snowyfoams/dog5/dog5_sdk/dog5_sdk/model/meshes/hip.stl

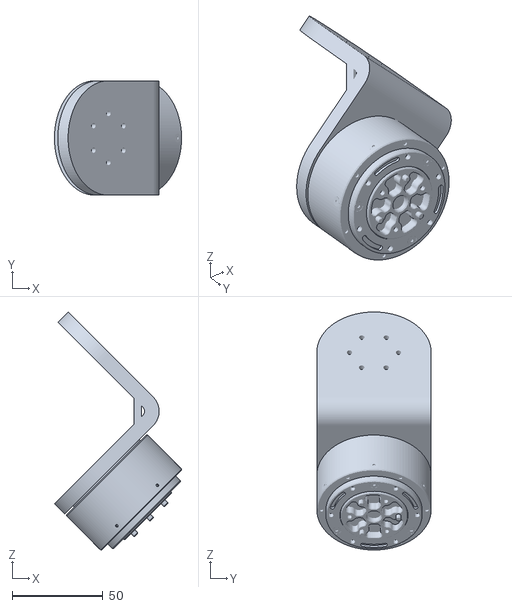
[picture p12: CAD file, 2026-08-26]
dog5_sdk/dog5_sdk/model/meshes/hip.stl
70.0 x 63.0 x 131.0
