snowyfoams/dog5/dog5_sdk/dog5_sdk/model/meshes/thigh.stl

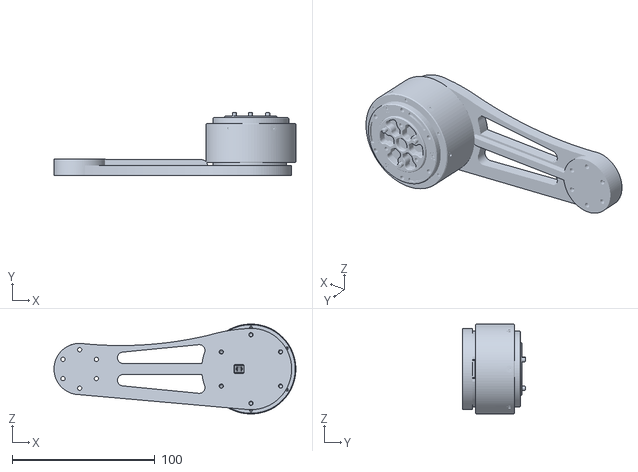
[picture p13: CAD file, 2026-08-26]
dog5_sdk/dog5_sdk/model/meshes/thigh.stl
169.6 x 44.0 x 63.0
