snowyfoams/dog5/dog5_sdk/dog5_sdk/model/meshes/shin.stl

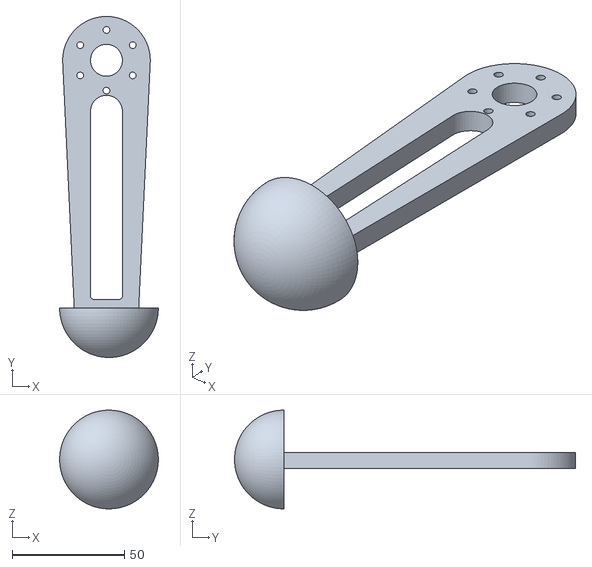
[picture p14: CAD file, 2026-08-26]
dog5_sdk/dog5_sdk/model/meshes/shin.stl
44.0 x 151.9 x 44.0
