snowyfoams/dog5/dog5_sdk/dog5_sdk/model/meshes/trunk.stl

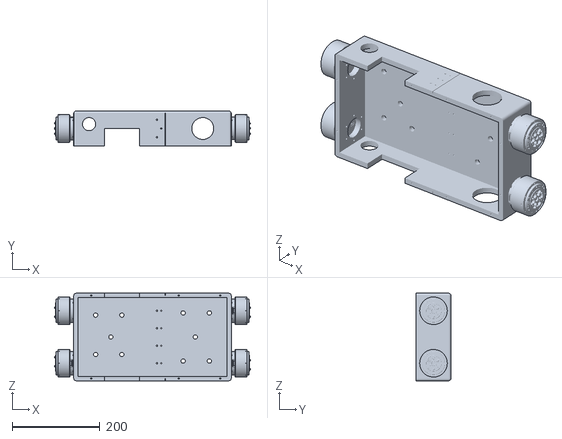
[picture p15: CAD file, 2026-08-26]
dog5_sdk/dog5_sdk/model/meshes/trunk.stl
448.0 x 80.0 x 200.0
