snowyfoams/dog5/dog5_sdk/dog5_sdk/sim.py

"""The MuJoCo backend: the same API as the robot, on the shipped MJCF.

    from dog5_sdk import Dog5Sim, JointPD, poses

    with Dog5Sim(pose="crouch", viewer=True) as robot:
        robot.run(JointPD(poses.stand_pose(0.15)), duration=5.0, tau_max=6.0)

WHAT THE MODEL IS
    ``model/dog5.xml`` is the robot's own MJCF, exported from the CAD and
    shipped here with its four meshes.  Its inertials are the CAD's, its
    ``armature`` is the real rotor inertia reflected through the 10:1
    reduction, and its actuators are direct-drive ``motor`` actuators with
    ``gear=1`` -- so ``data.ctrl`` IS joint torque in N*m, in the same units
    and the same order as the torque you send over CAN.  That is what makes
    one controller run on both.

    Bodies, joints, actuators and ``qpos[7:]`` are all in the canonical order
    (see :mod:`dog5_sdk.poses`), but this module looks every index up BY NAME
    anyway, so a future edit to the XML cannot silently transpose a leg.

WHAT THE SIMULATOR IS NOT
    It has no CAN bus, so no missed replies, no input-lost latch, no driver
    temperature and no 4 ms of round-robin phasing between the twelve joints.
    It has a rigid floor with MuJoCo's contact model, not a real one.  A
    controller that stands here will not necessarily stand on the robot -- the
    stack this SDK comes from documents a run where it did not.  What the
    simulator IS good for is the things that are true in both: the geometry,
    the mass distribution, the sign of every joint, the shape of your control
    law, and whether it saturates the torque cap.
"""
from __future__ import annotations

import math
import os

import numpy as np

from . import params as P
from . import poses
from .base import Dog5Robot
from .estimate import EncoderVelocity, leg_frames_all, trunk_estimate
from .hardware_map import HARDWARE_JOINTS
from .poses import LEGS, N_JOINTS
from .state import RobotState

#: The MJCF and its meshes, shipped inside the package.
MODEL_DIR = os.path.join(os.path.dirname(os.path.abspath(__file__)), "model")
MODEL_XML = os.path.join(MODEL_DIR, "dog5.xml")

#: Per-foot normal force counted as contact.  The robot weighs 57 N, so a
#: foot carrying 1 N is carrying nothing; this is a contact test, not a load
#: measurement.
CONTACT_FORCE_N = 1.0

#: Gains for the simulated position mode (``move_to``).  They stand in for the
#: drivers' own 0xA4 loop, which is a current-mode servo inside the motor and
#: is not modelled -- see the note in :meth:`Dog5Sim.move_to`.
POSITION_KP = 80.0
POSITION_KD = 3.0


def rpy_from_mat(mat) -> np.ndarray:
    """Roll, pitch, yaw from a body->world rotation matrix.

    Roll and pitch use the SAME definition as the hardware estimator
    (``estimator.C_from_rp`` / ``dynamic_model.attitude_rp``): the inertial
    up-axis expressed in the body frame.  A level robot reads 0, 0.
    """
    mat = np.asarray(mat, dtype=float).reshape(3, 3)
    g_b = mat.T @ np.array([0.0, 0.0, 1.0])      # up-axis, in the body frame
    roll = math.atan2(g_b[1], g_b[2])
    pitch = math.atan2(-g_b[0], math.hypot(g_b[1], g_b[2]))
    yaw = math.atan2(mat[1, 0], mat[0, 0])
    return np.array([roll, pitch, yaw])


class Dog5Sim(Dog5Robot):
    """DOG5 in MuJoCo, behind the :class:`dog5_sdk.base.Dog5Robot` interface.

    pose      starting pose: "crouch", "zero", "stand", or a (12,) vector
    viewer    open the interactive MuJoCo viewer (needs a display)
    realtime  pace the loop to wall-clock; off by default, because a headless
              run should go as fast as it can
    gravity   set to 0.0 to float the robot -- useful for checking a leg
              controller without the trunk falling over
    """

    name = "dog5-sim"

    def __init__(self, pose="crouch", *, viewer: bool = False,
                 realtime: bool = None, gravity: float = None,
                 control_hz: float = P.CONTROL_HZ, xml: str = MODEL_XML):
        super().__init__()
        import mujoco                                       # noqa: PLC0415

        self._mj = mujoco
        self.model = mujoco.MjModel.from_xml_path(xml)
        self.data = mujoco.MjData(self.model)
        self.control_hz = float(control_hz)

        if gravity is not None:
            self.model.opt.gravity[:] = (0.0, 0.0, -abs(float(gravity)))

        substeps = self.dt / self.model.opt.timestep
        self._substeps = max(1, int(round(substeps)))
        if abs(substeps - self._substeps) > 1e-9:
            raise ValueError(
                f"control period {self.dt * 1e3:.3f} ms is not a whole number "
                f"of MJCF timesteps ({self.model.opt.timestep * 1e3:.3f} ms); "
                "change control_hz or the XML timestep")

        self._index_by_name()
        self._realtime = bool(viewer) if realtime is None else bool(realtime)
        self._want_viewer = bool(viewer)
        self.viewer = None
        self._encoder_qd = EncoderVelocity()
        self._wall_deadline = None
        self._ctrl = np.zeros(N_JOINTS)

        self.reset(pose)

    # -- indexing --------------------------------------------------------
    def _index_by_name(self) -> None:
        mj, model = self._mj, self.model

        def ident(kind, name):
            index = mj.mj_name2id(model, kind, name)
            if index < 0:
                raise ValueError(f"{name!r} is not in {os.path.basename(MODEL_XML)}")
            return index

        names = [joint.model_name for joint in HARDWARE_JOINTS]
        self.joint_ids = [ident(mj.mjtObj.mjOBJ_JOINT, n) for n in names]
        self.actuator_ids = [ident(mj.mjtObj.mjOBJ_ACTUATOR, f"{n}_motor")
                             for n in names]
        self.qpos_adr = np.asarray([model.jnt_qposadr[i] for i in self.joint_ids])
        self.dof_adr = np.asarray([model.jnt_dofadr[i] for i in self.joint_ids])
        self.foot_site_ids = [ident(mj.mjtObj.mjOBJ_SITE, f"foot_{leg}")
                              for leg in LEGS]
        self.trunk_id = ident(mj.mjtObj.mjOBJ_BODY, "trunk")

        #: {geom id: leg index}, for the contact scan.
        self._leg_of_geom = {
            ident(mj.mjtObj.mjOBJ_GEOM, f"foot_{leg}"): index
            for index, leg in enumerate(LEGS)
        }

        self._sensor = {}
        for index in range(model.nsensor):
            name = mj.mj_id2name(model, mj.mjtObj.mjOBJ_SENSOR, index)
            adr, dim = model.sensor_adr[index], model.sensor_dim[index]
            self._sensor[name] = slice(adr, adr + dim)

    # -- state -----------------------------------------------------------
    def reset(self, pose="crouch", *, height: float = None, yaw: float = 0.0,
              settle_s: float = 0.15) -> "Dog5Sim":
        """Put the robot at `pose`, resting on the floor, and zero the clock.

        `pose` is "zero", "crouch", "stand" or a (12,) joint vector.  Unless
        `height` is given the trunk is dropped so the lowest collidable point
        just touches the floor, which is what you want in every case except
        deliberately studying a fall.

        `settle_s` then holds that pose against gravity for a moment.  Placed
        at exact contact the feet carry ZERO force, so nothing is in contact
        yet and the first tick would report ``contact=0000`` and a NaN height.
        Settling is what makes the first state a real standing state.  Set it
        to 0 to see the untouched placement.
        """
        q = self._resolve_pose(pose)
        self._mj.mj_resetData(self.model, self.data)
        self.data.qpos[self.qpos_adr] = q
        self.data.qvel[:] = 0.0

        half = 0.5 * float(yaw)
        self.data.qpos[3:7] = (math.cos(half), 0.0, 0.0, math.sin(half))
        self.data.qpos[0:3] = (0.0, 0.0, 1.0)     # provisional, see below

        if height is None:
            # Drop the robot until its LOWEST collidable point touches the
            # floor -- measured, not assumed to be a foot.  At the crouch it is
            # a foot; at the calibration pose the trunk itself is on the
            # ground, and starting a run with the trunk mesh through the floor
            # is a large impulse on the first step.
            self._mj.mj_forward(self.model, self.data)
            height = 1.0 - self._lowest_collidable_z()
        self.data.qpos[0:3] = (0.0, 0.0, float(height))

        self.data.ctrl[:] = 0.0
        self._ctrl[:] = 0.0
        self._mj.mj_forward(self.model, self.data)

        if settle_s > 0:
            self._hold_pose(q, int(round(settle_s * self.control_hz)))

        self.data.ctrl[:] = 0.0
        self._ctrl[:] = 0.0
        self._encoder_qd = EncoderVelocity()
        self._mj.mj_forward(self.model, self.data)
        self.t = 0.0
        self._wall_deadline = None
        return self

    def _hold_pose(self, q_ref, ticks: int) -> None:
        """Stiff joint PD onto `q_ref` for `ticks` control periods, no clock."""
        q_ref = np.asarray(q_ref, dtype=float).reshape(N_JOINTS)
        for _ in range(max(0, ticks)):
            q = self.data.qpos[self.qpos_adr]
            qd = self.data.qvel[self.dof_adr]
            tau = np.clip(POSITION_KP * (q_ref - q) - POSITION_KD * qd,
                          -9.0, 9.0)
            self.data.ctrl[self.actuator_ids] = tau
            for _ in range(self._substeps):
                self._mj.mj_step(self.model, self.data)
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
