snowyfoams/dog5/(commit log)

2026-08-26 DOG5: two months of quadruped work as seven readable chapters
    Assembled from two private repositories that had grown into each other:
    can_motor_control (the CAN layer) with dog_stand_compliance_control embedded
    as a gitlink that had no .gitmodules entry, so cloning the parent produced an
    empty directory. Both are tagged pre-public-reorg-2026-08-26 at the state this
    was built from.
    WHAT MOVED
    Source directories are named for what they do, and chapter identity lives in
    docs/ch1..ch7 plus an index in the README. Seven modules are genuinely shared
    by three or four chapters -- robot_base/stand_dog5_hw.py alone has 38
    importers -- so chapter-numbered code directories would have forced eit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
    [hip.stl, shin.stl, thigh.stl, trunk.stl]
2026-09-06 Ship only what ran on the robot: cut to the as-built trot stack
    The repository claimed seven chapters and 504 gates over an EKF, a convex
    MPC and a cone-constrained force QP. None of those three has ever been in
    the control loop. What actually flies -- and what the demo video is -- is a
    quasi-static single-rigid-body model fed by the AHRS directly, FK height and
    algebraic leg odometry, with force allocation by damped least squares and
    clamps.
    This cuts the tree to that: 180 tracked files to 80, four chapters, and 206
    offline gates over exactly the code that has been up and down on the machine.
    REMOVED, and named in the README rather than shipped
    state_estimator/ Bloesch error-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
    [calibrate12.py, params.py, safety.py]
2026-09-06 README: the frames and the kinematics, with the figures that show them
    The README opened on a MuJoCo stand-up GIF, which is the one thing this
    repository is not about. It now opens on six seconds of `trot_video/trot.MOV`
    -- the real robot, torque mode, walking out across the mat -- and the sim GIF
    is gone. `make_gif.py` still renders it; nothing links it any more.
    Under it is the part that was missing. "How it works" reads in the order it
    has to be read: the frames first, because every later bug is a missing
    rotation, then the leg, the model, the loop and the clock.
    1-3 the three frames, and the two coordinates nobody supplies; the
    DETA10 relabel that builds R_wb, and th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
    [hip.stl, shin.stl, thigh.stl, trunk.stl]
2026-09-09 yaw from IMU is truthable
